cy023/ATSAME54_DEVB/README.md

# ATSAME54_DEVB

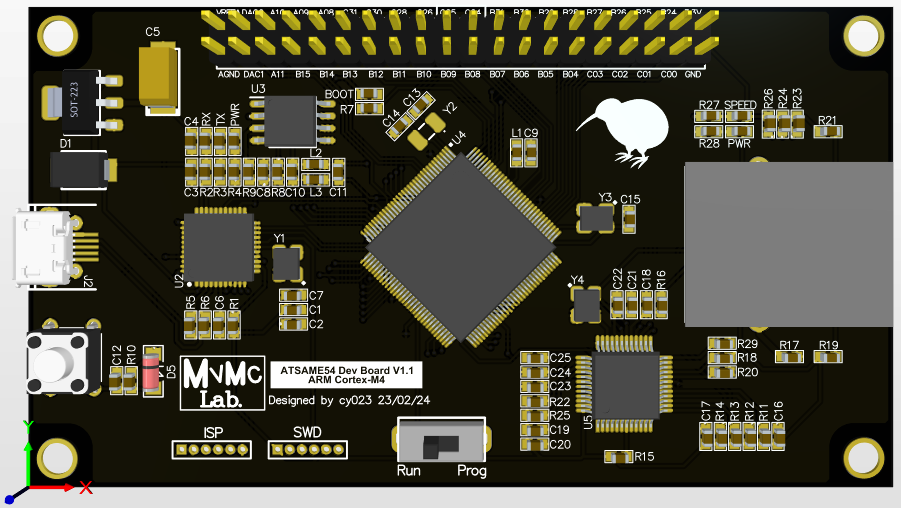
[picture p1: ATSAME54_DEVB_front.PNG]
front


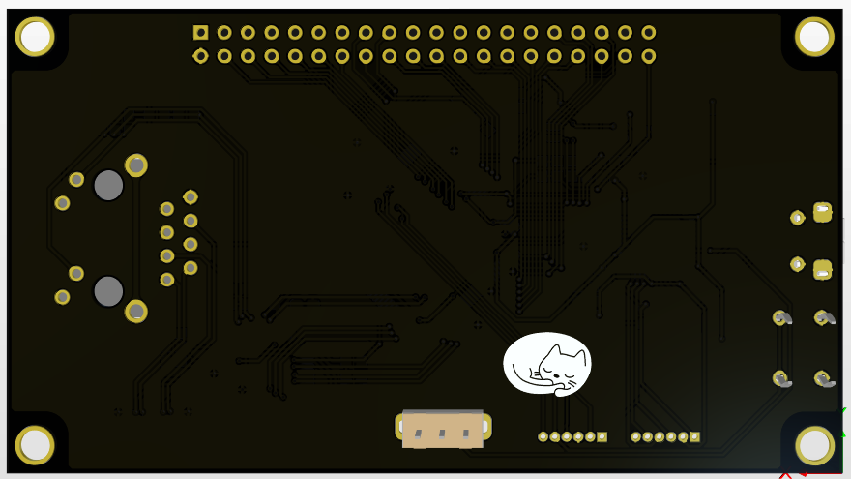
[picture p2: ATSAME54_DEVB_back.PNG]
back
