cy023/ATSAME54_DEVB/(list of files, drawings)

Other design files:
ATSAME54_DEVB.PcbLib
ATSAME54_DEVB.PrjPCB
ATSAME54_DEVB.SchLib
Aux_MCU_ATmega16U4.SchDoc
Main_MCU_ATSAME54.SchDoc
NIC_DP83848.SchDoc
