cy023/ATSAME54_DEVB/CHANGELOG.md

# V1.1 (2023-02-28)
Changed the CS pin of SPI flash (w25q128jv) from PB2 to PC6.
Added a flash boot indicator LED (PB2).
Corrected the wiring of TD+/TD- and RD+/RD- differential signals of Ethernet RJ45 port.

# V1.0 (2023-01-11)
Initial version.
